abbydes/ELEC5550_Group08_GITHUB/PCB PROTOTYPING/README.md

This folder contains the code used to verify hardware prototyping and the KiCad design files for the PCB
