abbydes/ELEC5550_Group08_GITHUB/USB/README.md

This folder contains the USB host and device examples for both HID and MSC USB subclasses.
