abbydes/ELEC5550_Group08_GITHUB/PCB PROTOTYPING/UART BRIDGE/README.md

This folder contains code for verifying the functional UART bridge
