abbydes/ELEC5550_Group08_GITHUB/MSC/usbtx_V1/readme.md

Polls for request for file on the UART and sends over the file via serial.
