abbydes/ELEC5550_Group08_GITHUB/PCB PROTOTYPING/ledpatch/README.md

Please follow the instructions in the file to implement the LED code into the main code. By default pin 6 is the LED power out.
