abbydes/ELEC5550_Group08_GITHUB/HID/code_flow_diagram_hid_device.png

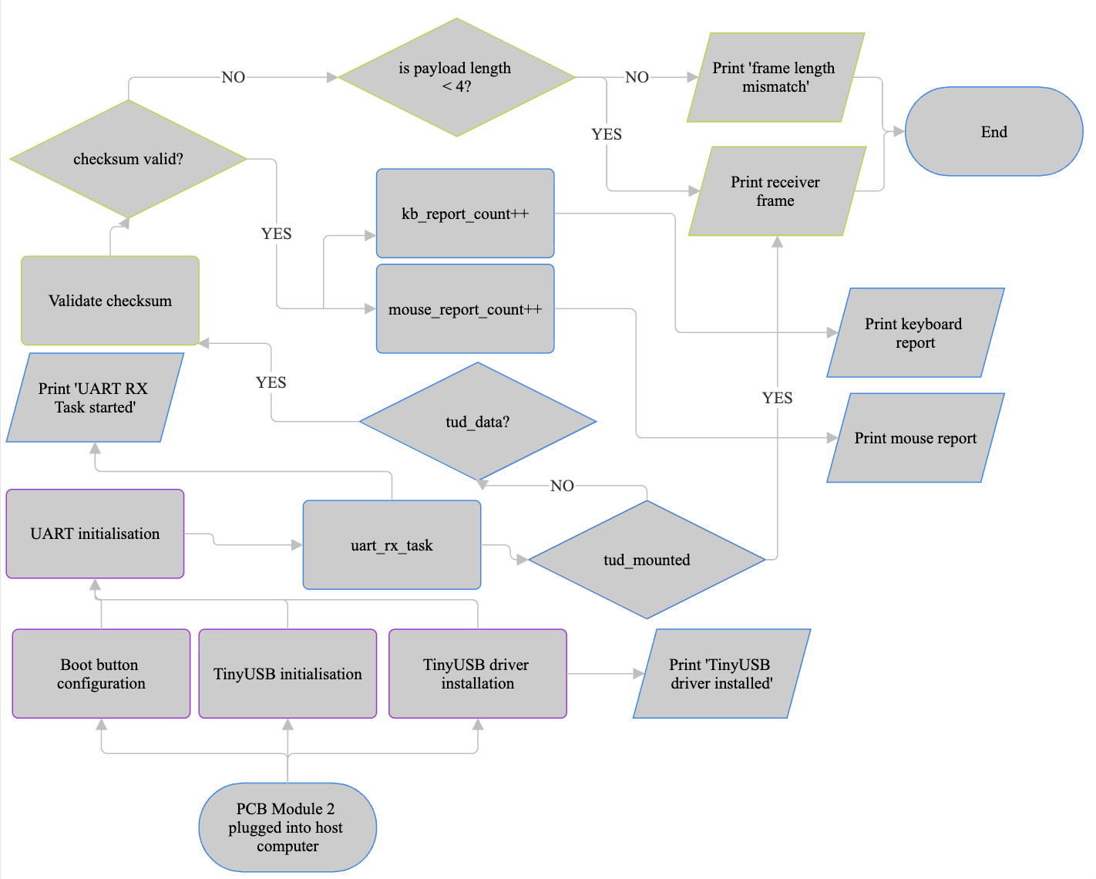
HID/code_flow_diagram_hid_device.png
