abbydes/ELEC5550_Group08_GITHUB/MSC/dev_main_V9/Module A Code Flow Diagram.png

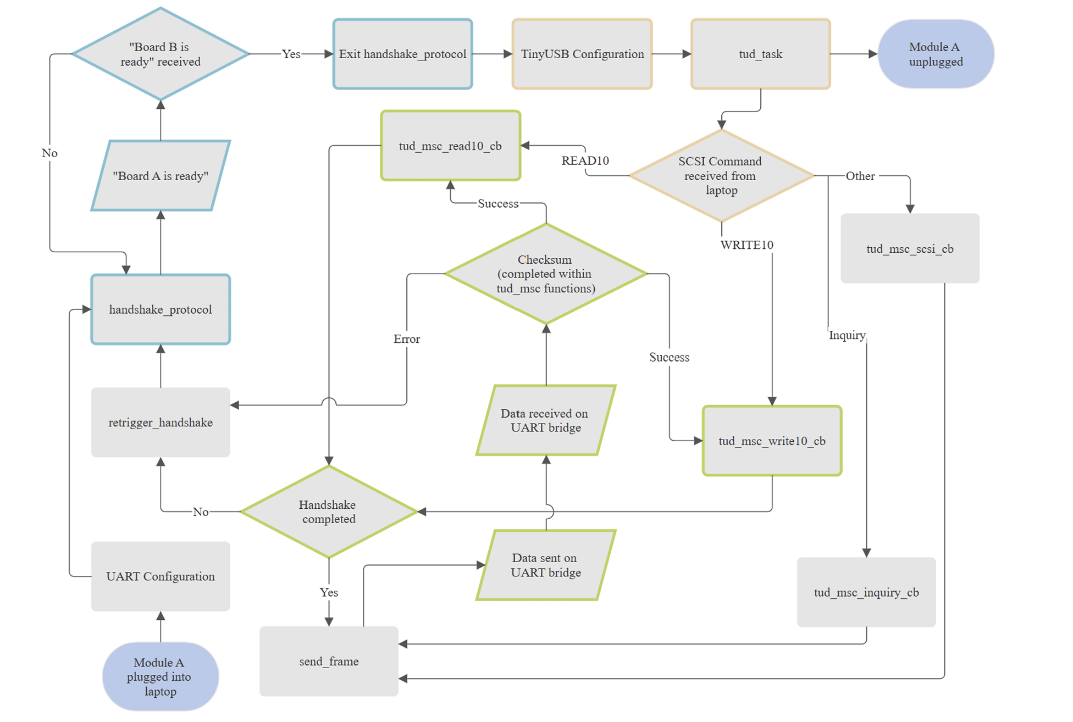
MSC/dev_main_V9/Module A Code Flow Diagram.png
