abbydes/ELEC5550_Group08_GITHUB/MSC/host_main_V8/Module B Code Flow Diagram.png

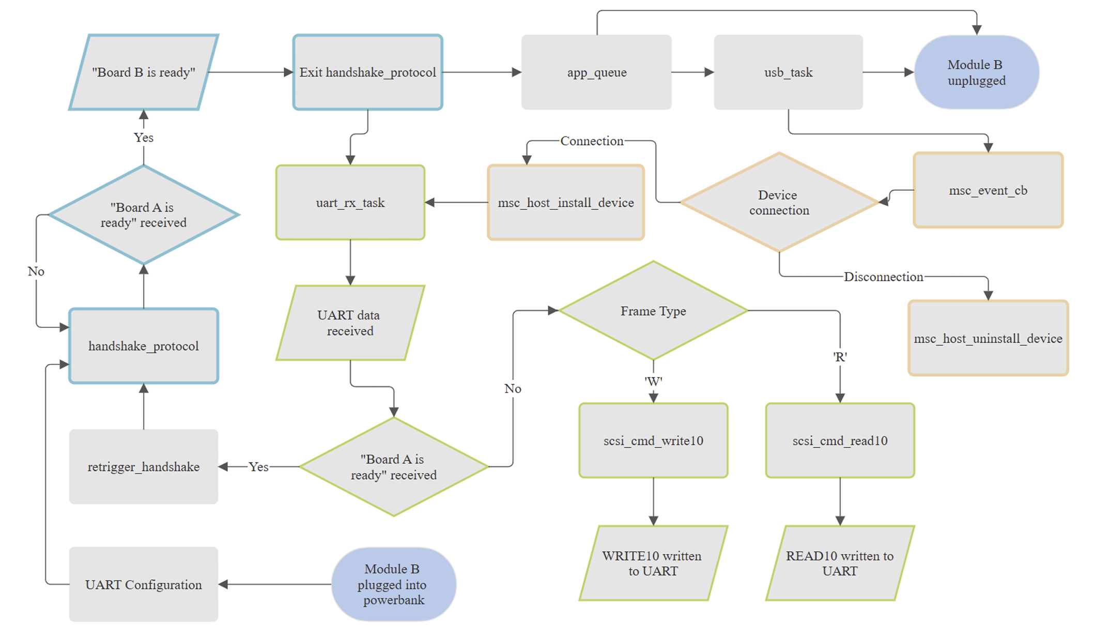
MSC/host_main_V8/Module B Code Flow Diagram.png
