abbydes/ELEC5550_Group08_GITHUB/PCB PROTOTYPING/KICAD DESIGN/IMPORTED COMPONENTS/README.md

This folder contains the necessary 3D models, symbols and footprints for the imported components used for the PCB design
