abbydes/ELEC5550_Group08_GITHUB/PCB PROTOTYPING/KICAD DESIGN/IMPORTED COMPONENTS/ESD9B5.0ST5G.stp

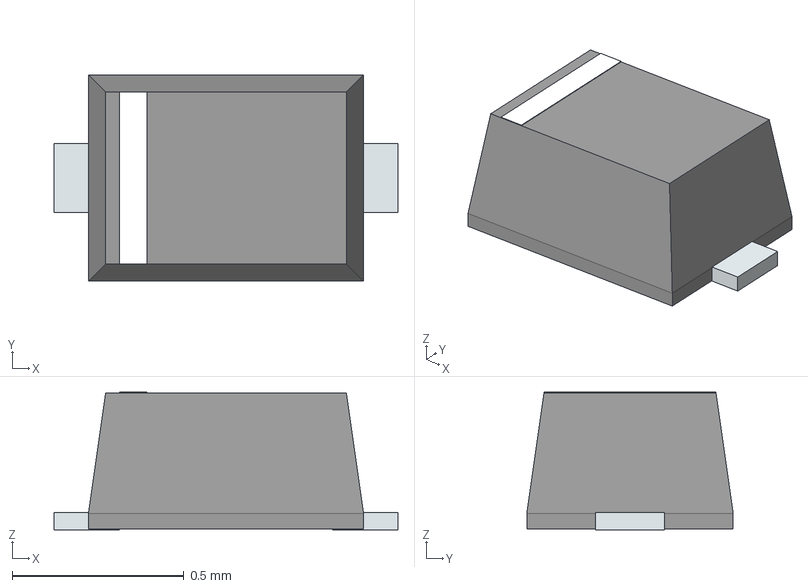
[picture p5: CAD file, 2025-10-27]
PCB PROTOTYPING/KICAD DESIGN/IMPORTED COMPONENTS/ESD9B5.0ST5G.stp
1.00 x 0.6 x 0.4 mm
PinKIdent
PinK
PinA
