abbydes/ELEC5550_Group08_GITHUB/PCB PROTOTYPING/KICAD DESIGN/IMPORTED COMPONENTS/ESP32-S3-WROOM-1-N8.stp

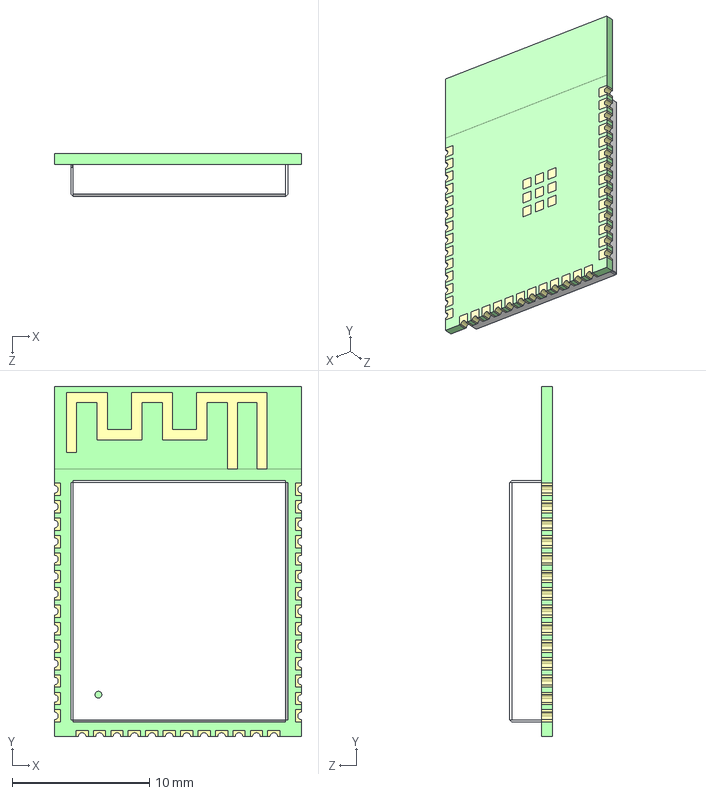
[picture p6: CAD file, 2025-10-27]
PCB PROTOTYPING/KICAD DESIGN/IMPORTED COMPONENTS/ESP32-S3-WROOM-1-N8.stp
18.0 x 25.5 x 3.10 mm
