abbydes/ELEC5550_Group08_GITHUB/PCB PROTOTYPING/KICAD DESIGN/IMPORTED COMPONENTS/USB4216-03-A.stp

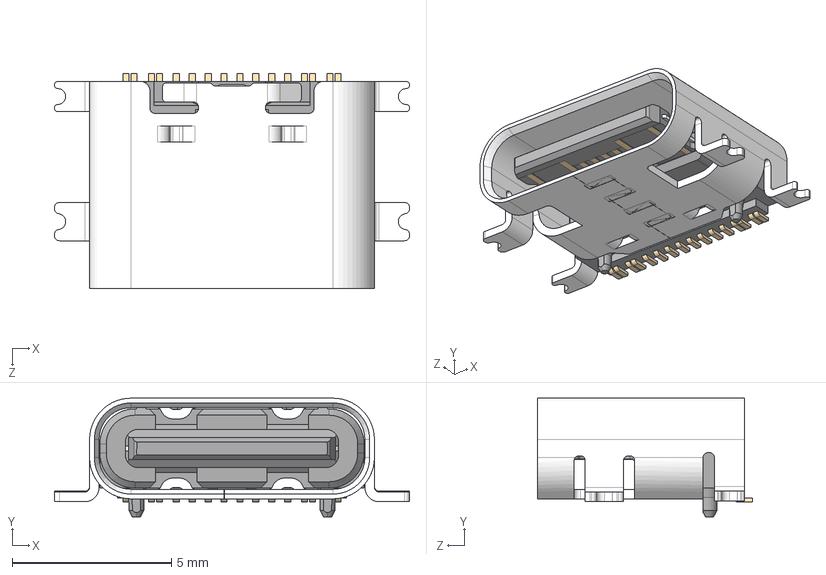
[picture p7: CAD file, 2025-10-27]
PCB PROTOTYPING/KICAD DESIGN/IMPORTED COMPONENTS/USB4216-03-A.stp
11.1 x 3.73 x 6.75 mm
USB4216 Shell
USB4216 Housing&Terminal
