abbydes/ELEC5550_Group08_GITHUB/PCB PROTOTYPING/KICAD DESIGN/IMPORTED COMPONENTS/LD1117AV33.stp

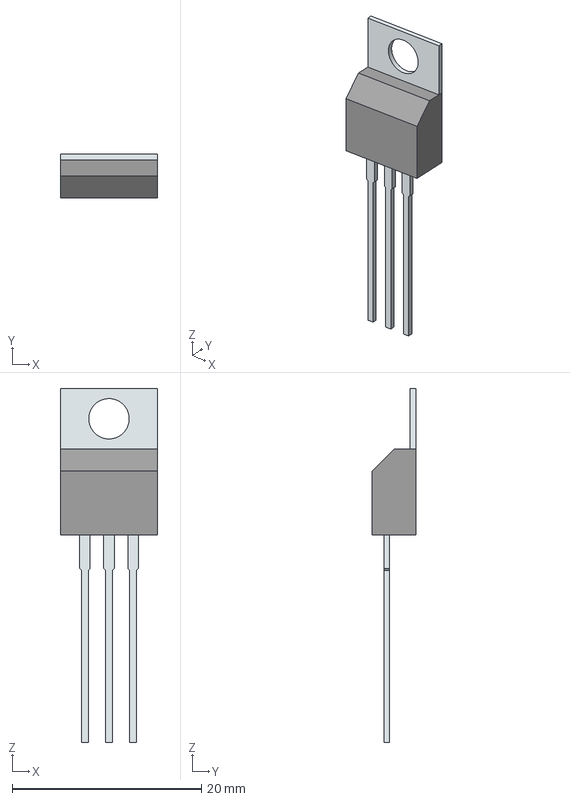
[picture p8: CAD file, 2025-10-27]
PCB PROTOTYPING/KICAD DESIGN/IMPORTED COMPONENTS/LD1117AV33.stp
10.2 x 4.60 x 37.4 mm
Tab
PinsArray
