abbydes/ELEC5550_Group08_GITHUB/PCB PROTOTYPING/KICAD DESIGN/IMPORTED COMPONENTS/TS18-5-15-SL-160-SMT-TR.stp

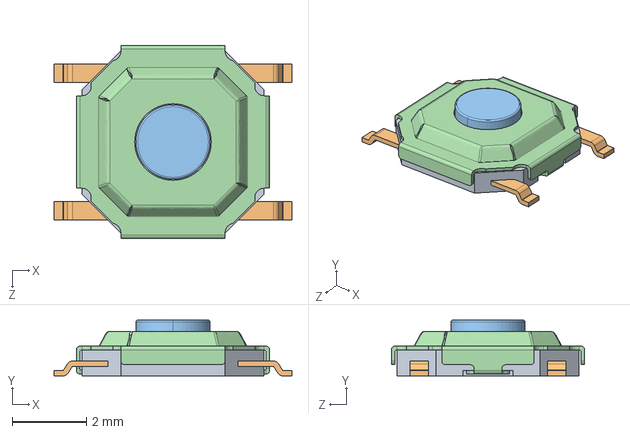
[picture p9: CAD file, 2025-10-27]
PCB PROTOTYPING/KICAD DESIGN/IMPORTED COMPONENTS/TS18-5-15-SL-160-SMT-TR.stp
6.40 x 1.50 x 5.20 mm
