abbydes/ELEC5550_Group08_GITHUB/PCB PROTOTYPING/KICAD DESIGN/IMPORTED COMPONENTS/TSM41YJ103KR05.stp

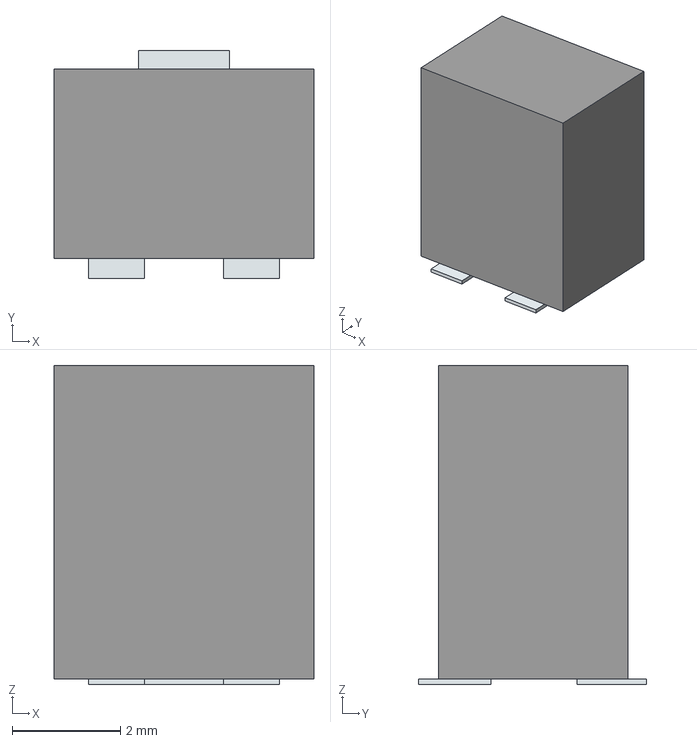
[picture p10: CAD file, 2025-10-27]
PCB PROTOTYPING/KICAD DESIGN/IMPORTED COMPONENTS/TSM41YJ103KR05.stp
4.80 x 4.21 x 5.90 mm
Pins
