abbydes/ELEC5550_Group08_GITHUB/PCB PROTOTYPING/KICAD DESIGN/IMPORTED COMPONENTS/LD1117S50TR.stp

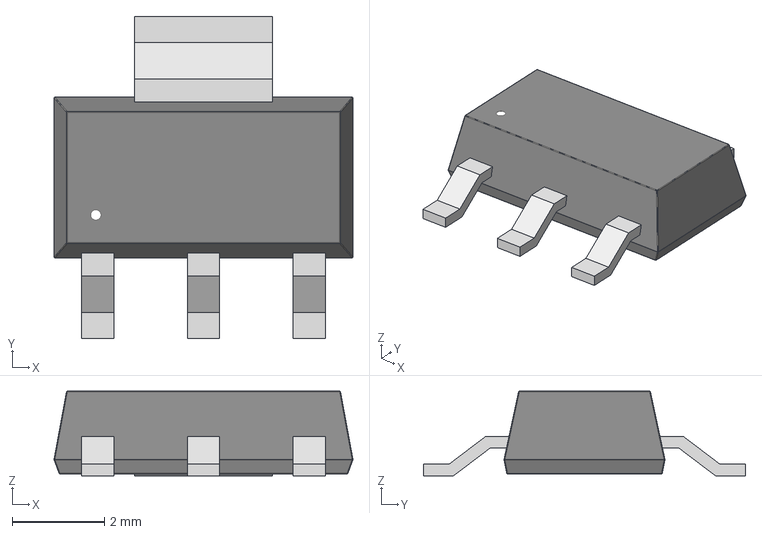
[picture p11: CAD file, 2025-10-27]
PCB PROTOTYPING/KICAD DESIGN/IMPORTED COMPONENTS/LD1117S50TR.stp
6.50 x 7.00 x 1.84 mm
