abbydes/ELEC5550_Group08_GITHUB/PCB PROTOTYPING/KICAD DESIGN/IMPORTED COMPONENTS/OPA323IDCKR.stp

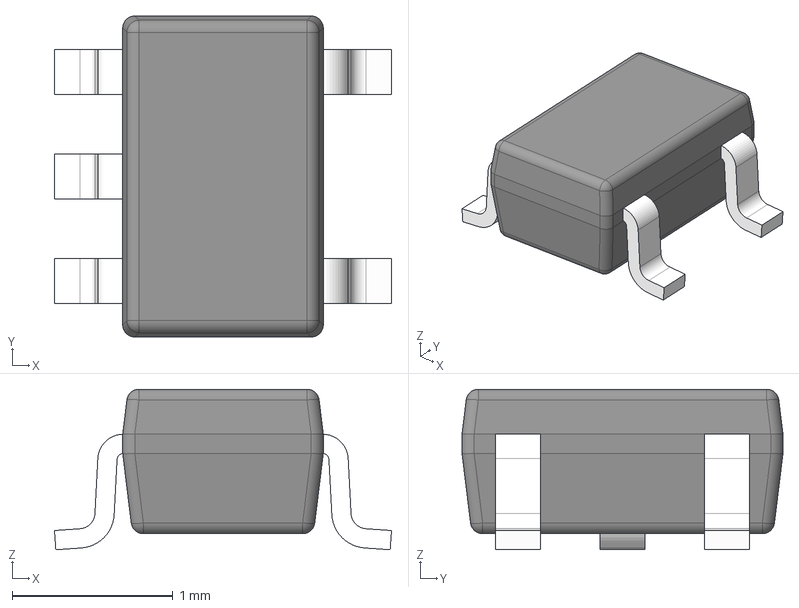
[picture p12: CAD file, 2025-10-27]
PCB PROTOTYPING/KICAD DESIGN/IMPORTED COMPONENTS/OPA323IDCKR.stp
2.10 x 2.00 x 1.00 mm
BODY-SOT
LEAD-SOT x 5
PIN1-ID
