abbydes/ELEC5550_Group08_GITHUB/PCB PROTOTYPING/KICAD DESIGN/IMPORTED COMPONENTS/VEMD5060X01.stp

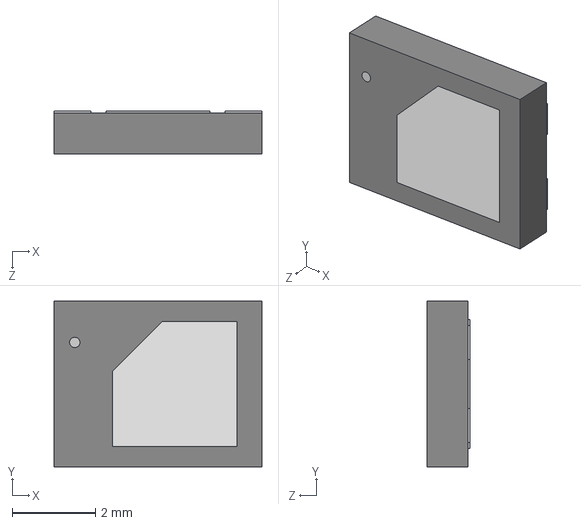
[picture p13: CAD file, 2025-10-27]
PCB PROTOTYPING/KICAD DESIGN/IMPORTED COMPONENTS/VEMD5060X01.stp
5.00 x 3.99 x 1.04 mm
