abbydes/ELEC5550_Group08_GITHUB/PCB PROTOTYPING/KICAD DESIGN/IMPORTED COMPONENTS/CP2102N-A02-GQFN28.stp

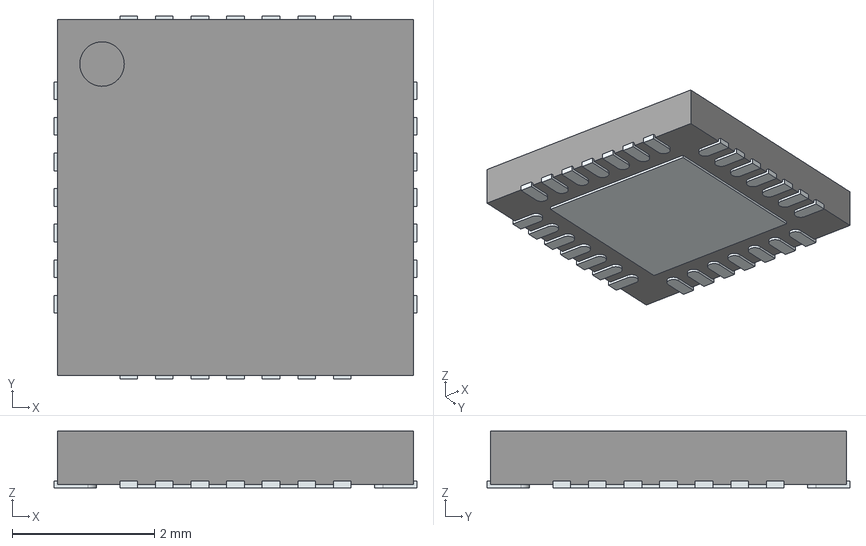
[picture p14: CAD file, 2025-10-27]
PCB PROTOTYPING/KICAD DESIGN/IMPORTED COMPONENTS/CP2102N-A02-GQFN28.stp
5.10 x 5.10 x 0.8 mm
ThermalPin
PinsArrayLR
PinsArrayTB
