abbydes/ELEC5550_Group08_GITHUB/PCB PROTOTYPING/KICAD DESIGN/IMPORTED COMPONENTS/3296W-1-105LF.stp

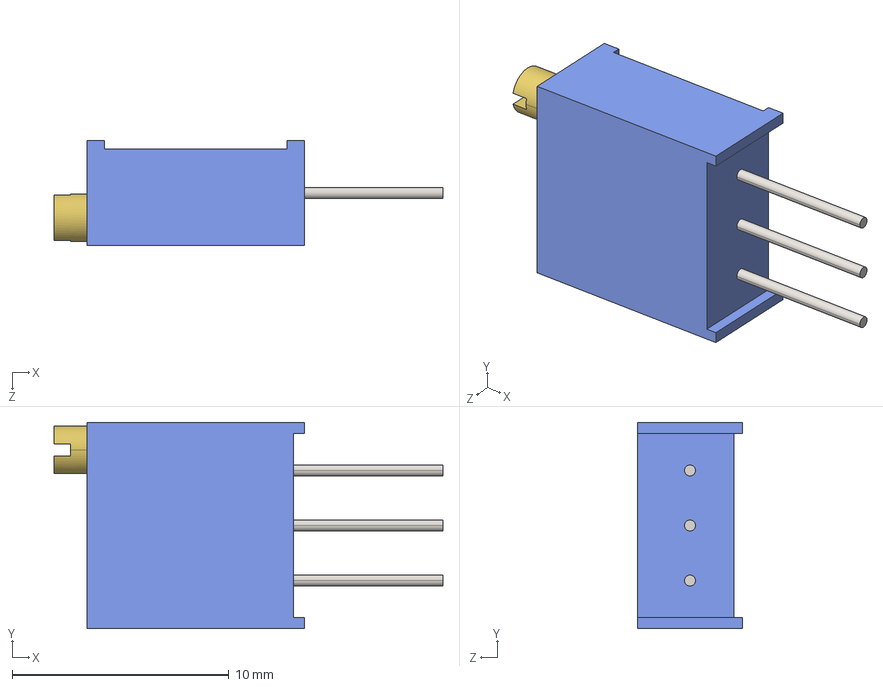
[picture p15: CAD file, 2025-10-27]
PCB PROTOTYPING/KICAD DESIGN/IMPORTED COMPONENTS/3296W-1-105LF.stp
18.0 x 9.52 x 4.83 mm
