abbydes/ELEC5550_Group08_GITHUB/PCB PROTOTYPING/KICAD DESIGN/IMPORTED COMPONENTS/OPA350UA.stp

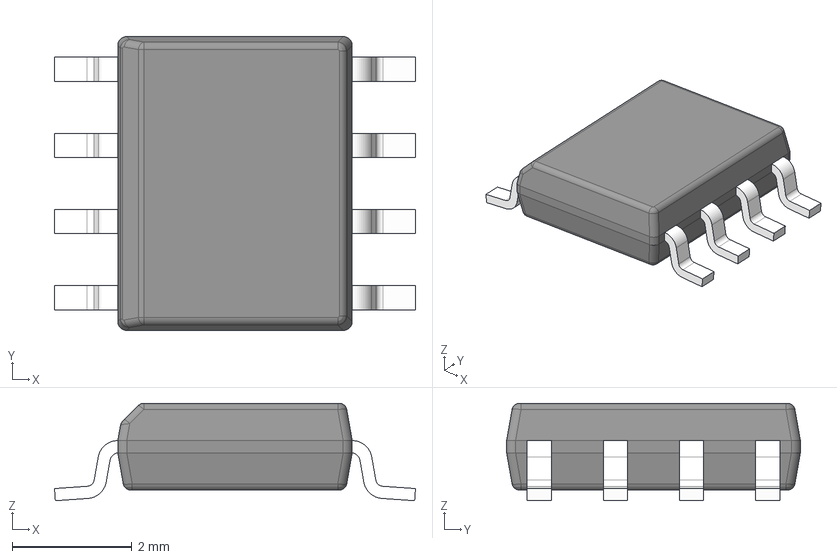
[picture p16: CAD file, 2025-10-27]
PCB PROTOTYPING/KICAD DESIGN/IMPORTED COMPONENTS/OPA350UA.stp
6.02 x 4.90 x 1.63 mm
BODY-SO
LEAD-D0008A x 8
