abbydes/ELEC5550_Group08_GITHUB/PCB PROTOTYPING/KICAD DESIGN/IMPORTED COMPONENTS/PTS647SN50SMTR2_LFS.stp

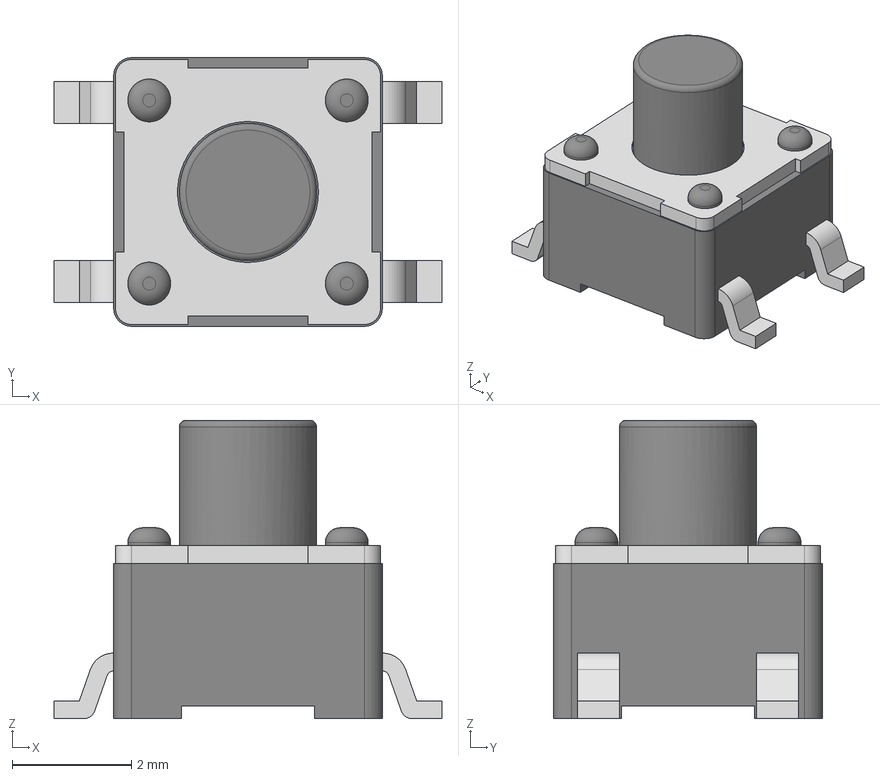
[picture p17: CAD file, 2025-10-27]
PCB PROTOTYPING/KICAD DESIGN/IMPORTED COMPONENTS/PTS647SN50SMTR2_LFS.stp
6.50 x 4.50 x 5.00 mm
