abbydes/ELEC5550_Group08_GITHUB/PCB PROTOTYPING/KICAD DESIGN/IMPORTED COMPONENTS/1N5819HW-7-F.stp

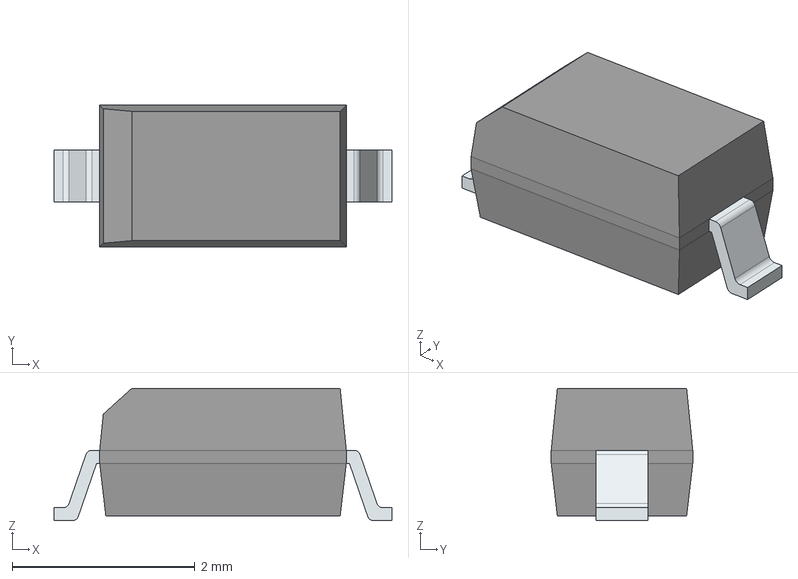
[picture p18: CAD file, 2025-10-27]
PCB PROTOTYPING/KICAD DESIGN/IMPORTED COMPONENTS/1N5819HW-7-F.stp
3.70 x 1.55 x 1.45 mm
FilletPinL
FilletPinR
