abbydes/ELEC5550_Group08_GITHUB/PCB PROTOTYPING/KICAD DESIGN/IMPORTED COMPONENTS/AP2112K-3.3TRG1.stp

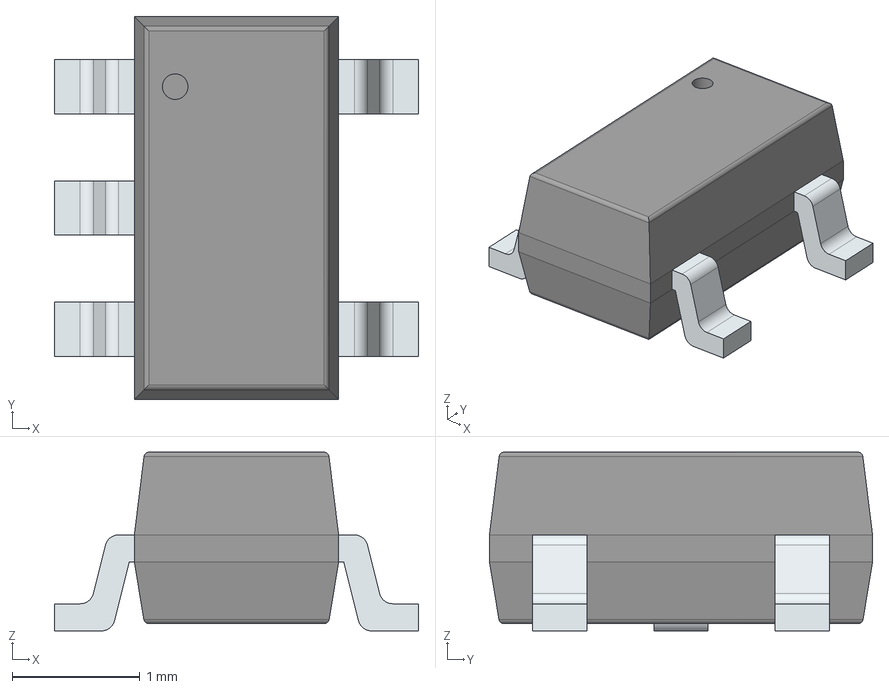
[picture p19: CAD file, 2025-10-27]
PCB PROTOTYPING/KICAD DESIGN/IMPORTED COMPONENTS/AP2112K-3.3TRG1.stp
2.85 x 3.00 x 1.40 mm
PinsArrayL
PinsArrayR
