abbydes/ELEC5550_Group08_GITHUB/PCB PROTOTYPING/KICAD DESIGN/IMPORTED COMPONENTS/DIODE_TEMD5010_VIS.step

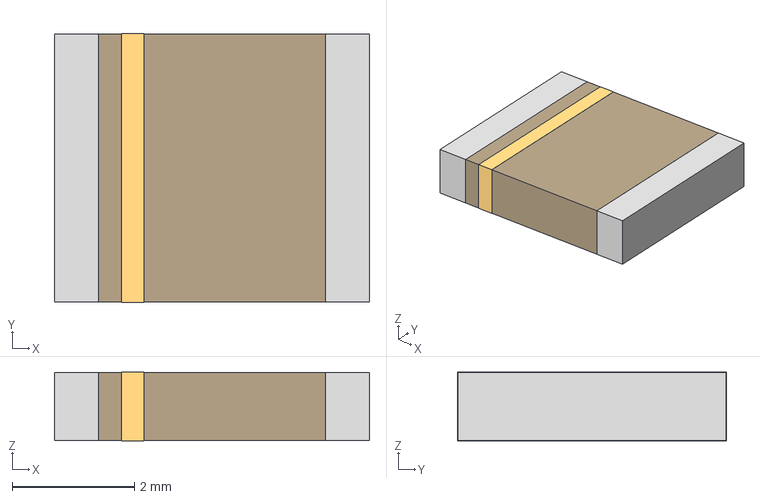
[picture p20: CAD file, 2025-10-27]
PCB PROTOTYPING/KICAD DESIGN/IMPORTED COMPONENTS/DIODE_TEMD5010_VIS.step
5.16 x 4.40 x 1.12 mm

PCB PROTOTYPING/KICAD DESIGN/IMPORTED COMPONENTS/OPA380AIDGKR.stp
4.90 x 3.00 x 1.10 mm
BODY_MUA08A
LEAD_MUA08A x 8
