abbydes/ELEC5550_Group08_GITHUB/(list of files, cad)

Other CAD files:
PCB PROTOTYPING/KICAD DESIGN/IMPORTED COMPONENTS/CP2102N-A02-GQFN28R.stp
PCB PROTOTYPING/KICAD DESIGN/IMPORTED COMPONENTS/TLV75733PDRVR.stp
