abbydes/ELEC5550_Group08_GITHUB/PCB PROTOTYPING/KICAD DESIGN/ESP32-S3-DevKitC-1.kicad_pcb

## KiCad design PCB PROTOTYPING/KICAD DESIGN/ESP32-S3-DevKitC-1.kicad_pcb (2025-10-27)

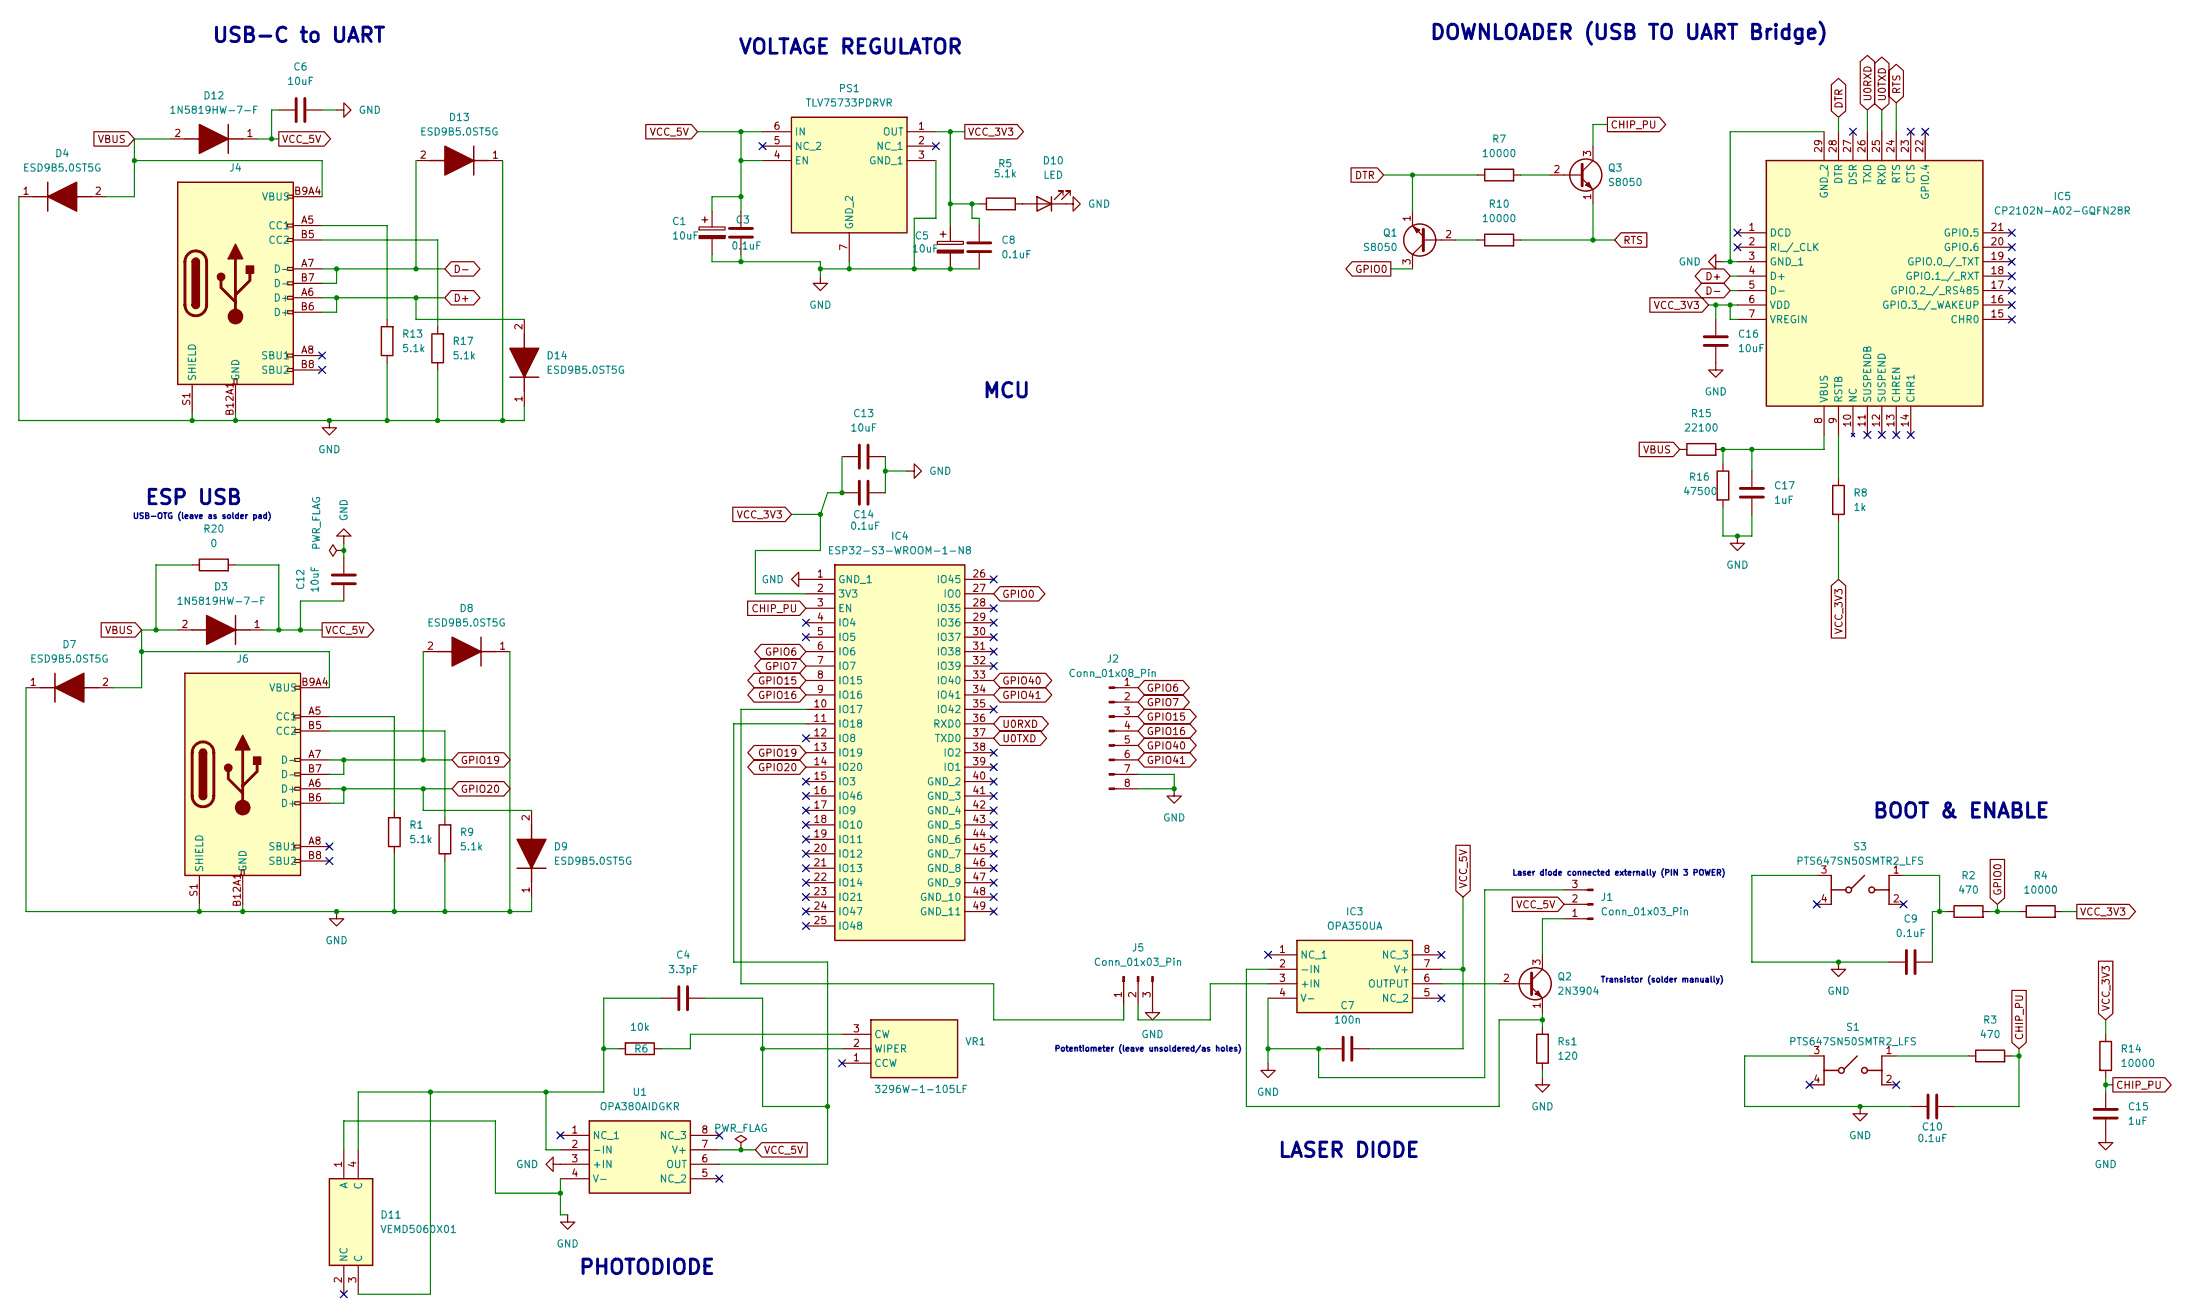
[picture p22: schematic ESP32-S3-DevKitC-1.kicad_sch]

Parts:
C1, C5, C6, C12, C13, C16: 10uF; C_0805_2012Metric
C3, C8, C9, C10, C14: 0.1uF; C_0805_2012Metric
C4: 3.3pF; C_0805_2012Metric
C7: 100n; C_0805_2012Metric
C15, C17: 1uF; C_0805_2012Metric
D3, D12: 1N5819HW-7-F; SOD3716X145N; Mouser Part Number 621-1N5819HW-F
D4, D7, D8, D9, D13, D14: ESD9B5.0ST5G; SODFL1006X40N; Mouser Part Number 863-ESD9B5.0ST5G
D10: LED; LED_0805_2012Metric
D11: VEMD5060X01; Mouser Part Number 78-VEMD5060X01
IC3: OPA350UA; SOIC127P600X175-8N; Mouser Part Number 595-OPA350UA
IC4: ESP32-S3-WROOM-1-N8; ESP32S3WROOM1N8R2; Mouser Part Number 356-ESP32-S3WROOM1N8
IC5: CP2102N-A02-GQFN28R; QFN50P500X500X80-29N-D; Mouser Part Number 634-CP2102NA02QFN28R
J1, J5: Conn_01x03_Pin; PinHeader_1x03_P2.54mm_Vertical
J2: Conn_01x08_Pin; PinHeader_1x08_P2.54mm_Vertical
J4, J6: Connector, USB-TYPE-C-16P; TYPE-C-SMD_HX-TYPE-C-16PIN; LCSC C2927039
PS1: TLV75733PDRVR; SON65P200X200X80-7N; Mouser Part Number 595-TLV75733PDRVR
Q1, Q3: S8050; TO-92_Inline
Q2: 2N3904; TO-92_Inline
R1, R5, R9, R13, R17: 5.1k; R_0805_2012Metric
R2, R3: 470; R_0805_2012Metric
R4, R7, R10, R14: 10000; R_0805_2012Metric
R6: 10k; R_0805_2012Metric
R8: 1k; R_0805_2012Metric
R15: 22100; R_0805_2012Metric
R16: 47500; R_0805_2012Metric
R20: 0; R_0805_2012Metric
Rs1: 120; R_0805_2012Metric
S1, S3: PTS647SN50SMTR2_LFS; PTS647SK50SMTR2LFS; Manufacturer_Part_Number PTS647SN50SMTR2 LFS
U1: OPA380AIDGKR; SOP65P490X110-8N; Mouser Part Number 595-OPA380AIDGKR
VR1: 3296W-1-105LF; 3296W1503LF; Mouser Part Number 652-3296W-1-105LF

Connections:
CHIP_PU: C10.2, C15.2, IC4.3 (EN), Q3.3 (C), R3.2, R14.2
D+: D14.2 (A), IC5.4 (D+), J4.A6 (D+), J4.B6 (D+)
D-: D13.2 (A), IC5.5 (D-), J4.A7 (D-), J4.B7 (D-)
DTR: IC5.28 (DTR), Q1.1 (E), R7.1
GND: C1.2, C3.2, C5.2, C6.2, C7.2, C8.2, C9.1, C10.1, C12.2, C13.2, C14.2, C15.1, C16.1, C17.1, D4.1 (K), D7.1 (K), D8.1 (K), D9.1 (K), D10.1 (K), D11.1 (A), D13.1 (K), D14.1 (K), IC3.4 (V-), IC4.1 (GND_1), IC5.3 (GND_1), IC5.29 (GND_2), J1.3, J2.7, J2.8, J4.A12B1 (GND), J4.B12A1 (GND), J4.S1 (SHIELD), J5.3, J6.A12B1 (GND), J6.B12A1 (GND), J6.S1 (SHIELD), PS1.3 (GND_1), PS1.7 (GND_2), R1.1, R9.1, R13.1, R16.2, R17.1, Rs1.1, S1.3 (COM_1), S3.3 (COM_1), U1.3 (+IN), U1.4 (V-)
GPIO0: IC4.27 (IO0), Q1.3 (C), R2.2, R4.1
GPIO6: IC4.6 (IO6), J2.1
GPIO7: IC4.7 (IO7), J2.2
GPIO15: IC4.8 (IO15), J2.3
GPIO16: IC4.9 (IO16), J2.4
GPIO19: D8.2 (A), IC4.13 (IO19), J6.A7 (D-), J6.B7 (D-)
GPIO20: D9.2 (A), IC4.14 (IO20), J6.A6 (D+), J6.B6 (D+)
GPIO40: IC4.33 (IO40), J2.5
GPIO41: IC4.34 (IO41), J2.6
unnamed: D10.2 (A), R5.2
unnamed: IC3.3 (+IN), J5.2
unnamed: IC3.2 (-IN), Q2.1 (E), Rs1.2
unnamed: IC3.6 (OUTPUT), Q2.2 (B)
unnamed: IC4.10 (IO17), J5.1
unnamed: C4.1, IC4.11 (IO18), U1.6 (OUT), VR1.2 (WIPER)
unnamed: IC5.9 (RSTB), R8.1
unnamed: C17.2, IC5.8 (VBUS), R15.2, R16.1
unnamed: J1.1, Q2.3 (C)
unnamed: J4.A5 (CC1), R13.2
unnamed: J4.B5 (CC2), R17.2
unnamed: J6.A5 (CC1), R1.2
unnamed: J6.B5 (CC2), R9.2
unnamed: Q1.2 (B), R10.1
unnamed: Q3.2 (B), R7.2
unnamed: R3.1, S1.1 (NO_1)
unnamed: C9.2, R2.1, S3.1 (NO_1)
unnamed: C4.2, D11.3 (C), D11.4 (C), R6.2, U1.2 (-IN)
unnamed: R6.1, VR1.3 (CW)
RTS: IC5.24 (RTS), Q3.1 (E), R10.2
U0RXD: IC4.36 (RXD0), IC5.26 (TXD)
U0TXD: IC4.37 (TXD0), IC5.25 (RXD)
VBUS: D3.2 (A), D4.2 (A), D7.2 (A), D12.2 (A), J4.A9B4 (VBUS), J4.B9A4 (VBUS), J6.A9B4 (VBUS), J6.B9A4 (VBUS), R15.1, R20.1
VCC_3V3: C5.1, C8.1, C13.1, C14.1, C16.2, IC4.2 (3V3), IC5.6 (VDD), IC5.7 (VREGIN), PS1.1 (OUT), R4.2, R5.1, R8.2, R14.1
VCC_5V: C1.1, C3.1, C6.1, C7.1, C12.1, D3.1 (K), D12.1 (K), IC3.7 (V+), J1.2, PS1.4 (EN), PS1.6 (IN), R20.2, U1.7 (V+)

Notes on the sheet:
LASER DIODE
MCU
BOOT & ENABLE
USB-OTG (leave as solder pad)
PHOTODIODE
Potentiometer (leave unsoldered/as holes)
USB-C to UART
Laser diode connected externally (PIN 3 POWER)
VOLTAGE REGULATOR
Transistor (solder manually)
ESP USB
DOWNLOADER (USB TO UART Bridge)

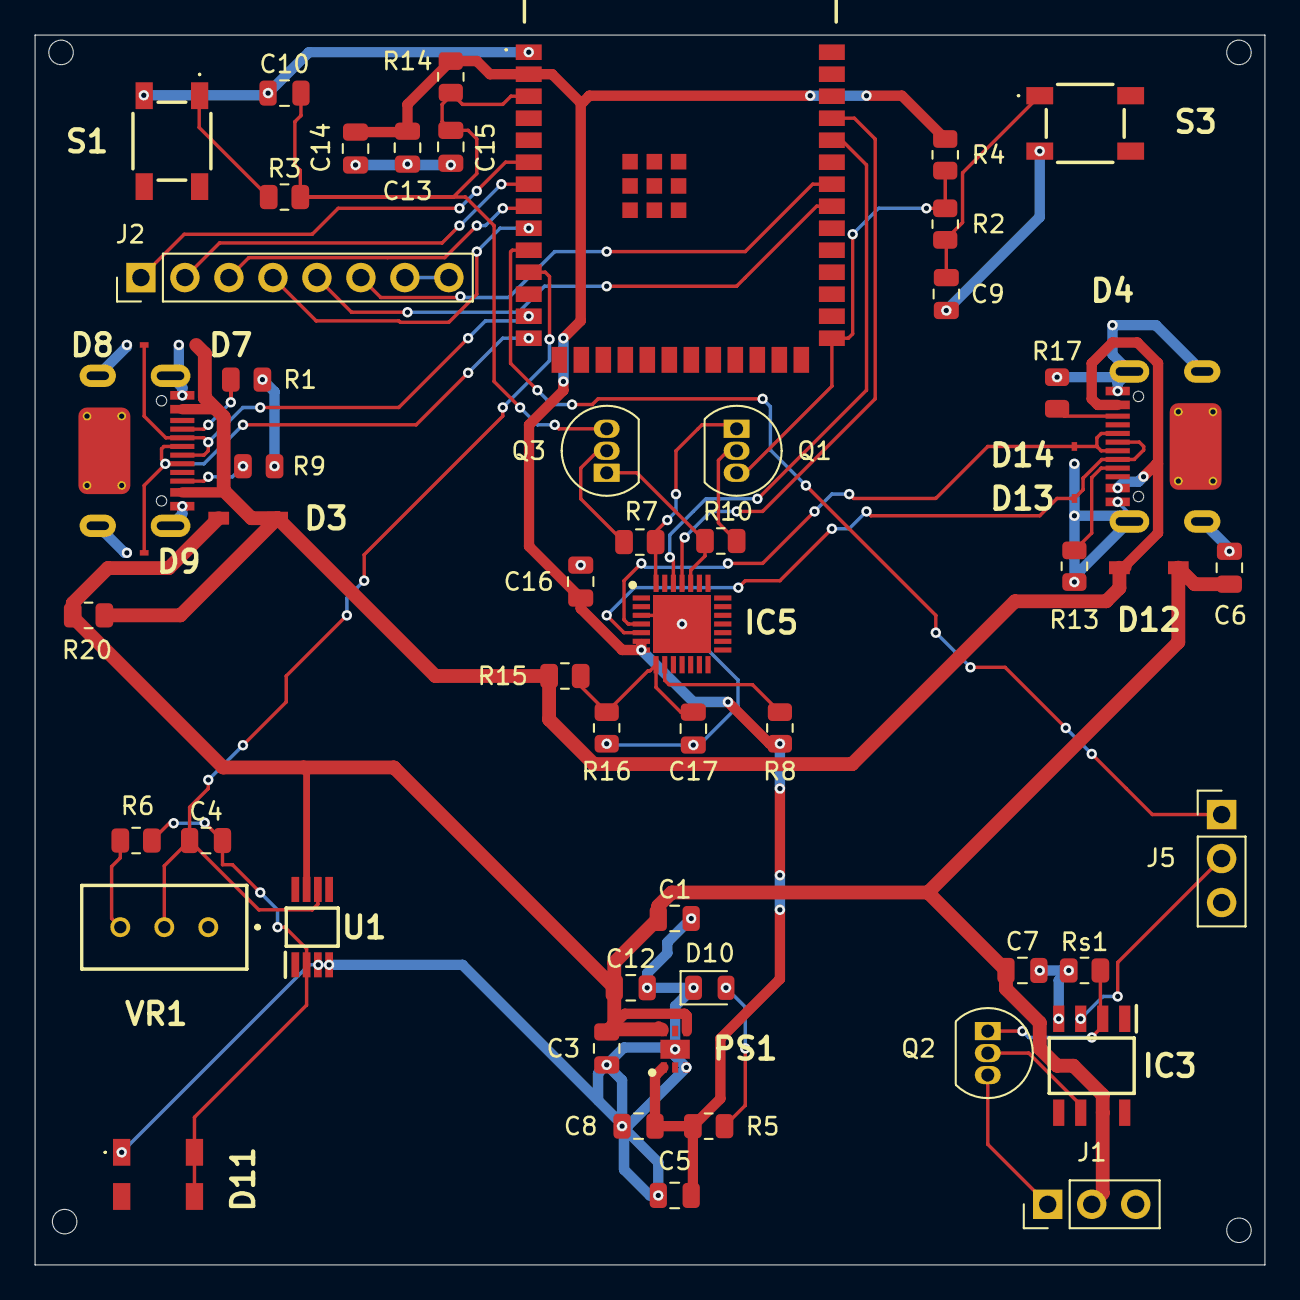
[picture p23: board ESP32-S3-DevKitC-1.kicad_pcb from above]

Board: 2 copper layers, 71.0 x 71.0 mm, 58 parts (0 on the bottom side), 39 nets.
