abbydes/ELEC5550_Group08_GITHUB/HID/hid_v1.c

/*
 * SPDX-FileCopyrightText: 2022-2025 Espressif Systems (Shanghai) CO LTD
 *
 * SPDX-License-Identifier: Unlicense OR CC0-1.0
 */

#include <stdio.h>
#include <stdbool.h>
#include <string.h>
#include <unistd.h>
#include "freertos/FreeRTOS.h"
#include "freertos/task.h"
#include "freertos/event_groups.h"
#include "freertos/queue.h"
#include "esp_err.h"
#include "esp_log.h"
#include "usb/usb_host.h"
#include "errno.h"
#include "driver/gpio.h"
#include "usb/hid_host.h"
#include "usb/hid_usage_keyboard.h"
#include "usb/hid_usage_mouse.h"
#include "driver/uart.h"
#include "string.h"

#include <stdlib.h>
#include "tinyusb.h"
#include "class/hid/hid_device.h"

/* GPIO Pin number for quit from example logic */
#define APP_QUIT_PIN                GPIO_NUM_0

static const char *TAG = "example";

// ---------------- UART framing to GPIO17 (ESP32-S3) ----------------
#define SERIAL_UART_NUM   UART_NUM_1
#define SERIAL_TX_GPIO    17
#define SERIAL_BAUD       115200
#define SERIAL_MAGIC      0xA5
#define UART_RX_PIN        18              // Match sender TX, supposed to be GPIO18
#define UART_BUF_SIZE      1024

static inline uint8_t checksum8(const uint8_t *data, size_t len)
{
    uint32_t s = 0;
    for (size_t i = 0; i < len; i++) {
        s += data[i];
    }
    return (uint8_t)(s & 0xFF);
}

static void uart_init(void)
{
    const uart_config_t cfg = {
        .baud_rate = SERIAL_BAUD,
        .data_bits = UART_DATA_8_BITS,
        .parity    = UART_PARITY_DISABLE,
        .stop_bits = UART_STOP_BITS_1,
        .flow_ctrl = UART_HW_FLOWCTRL_DISABLE,
        .source_clk = UART_SCLK_DEFAULT,
    };
    // Minimal RX buffer (we only TX), no event queue
    ESP_ERROR_CHECK(uart_driver_install(SERIAL_UART_NUM, 256, 0, 0, NULL, 0));
    ESP_ERROR_CHECK(uart_param_config(SERIAL_UART_NUM, &cfg));
    ESP_ERROR_CHECK(uart_set_pin(SERIAL_UART_NUM, SERIAL_TX_GPIO,
                                 UART_PIN_NO_CHANGE, UART_PIN_NO_CHANGE,
                                 UART_PIN_NO_CHANGE));
}

// Send one framed packet over UART (TYPE: 'K'/'M'/'R')
static void uart_send_framed(uint8_t type, const uint8_t *payload, size_t len)
{
    if (!payload || len > 250) return; // sanity limit

    uint8_t hdr[3] = { SERIAL_MAGIC, type, (uint8_t)len };

    // Compute checksum over TYPE + LEN + payload
    uint32_t sum = hdr[1] + hdr[2];
    for (size_t i = 0; i < len; i++) {
        sum += payload[i];
    }
    uint8_t cs = (uint8_t)(0x100 - (sum & 0xFF));

    uint8_t buf[3 + len + 1];
    memcpy(buf, hdr, 3);
    memcpy(buf + 3, payload, len);
    buf[3 + len] = cs;

    //Send out over UART
    (void)uart_write_bytes(SERIAL_UART_NUM, (const char *)buf, sizeof(buf));
}
// -------------------------------------------------------------------


QueueHandle_t app_event_queue = NULL;

/**
 * @brief APP event group
 *
 * Application logic can be different. There is a one among other ways to distinguish the
 * event by application event group.
 * In this example we have two event groups:
 * APP_EVENT            - General event, which is APP_QUIT_PIN press event (Generally, it is IO0).
 * APP_EVENT_HID_HOST   - HID Host Driver event, such as device connection/disconnection or input report.
 */
typedef enum {
    APP_EVENT = 0,
    APP_EVENT_HID_HOST
} app_event_group_t;

/**
 * @brief APP event queue
 *
 * This event is used for delivering the HID Host event from callback to a task.
 */
typedef struct {
    app_event_group_t event_group;
    /* HID Host - Device related info */
    struct {
        hid_host_device_handle_t handle;
        hid_host_driver_event_t event;
        void *arg;
    } hid_host_device;
} app_event_queue_t;

/**
 * @brief HID Protocol string names
 */
static const char *hid_proto_name_str[] = {
    "NONE",
    "KEYBOARD",
    "MOUSE"
};

/**
 * @brief Key event
 */
typedef struct {
    enum key_state {
        KEY_STATE_PRESSED = 0x00,
        KEY_STATE_RELEASED = 0x01
    } state;
    uint8_t modifier;
    uint8_t key_code;
} key_event_t;

/* Main char symbol for ENTER key */
#define KEYBOARD_ENTER_MAIN_CHAR    '\r'
/* When set to 1 pressing ENTER will be extending with LineFeed during serial debug output */
#define KEYBOARD_ENTER_LF_EXTEND    1

/**
 * @brief Scancode to ascii table
 */
const uint8_t keycode2ascii [57][2] = {
    {0, 0}, /* HID_KEY_NO_PRESS        */
    {0, 0}, /* HID_KEY_ROLLOVER        */
    {0, 0}, /* HID_KEY_POST_FAIL       */
    {0, 0}, /* HID_KEY_ERROR_UNDEFINED */
    {'a', 'A'}, /* HID_KEY_A               */
    {'b', 'B'}, /* HID_KEY_B               */
    {'c', 'C'}, /* HID_KEY_C               */
    {'d', 'D'}, /* HID_KEY_D               */
    {'e', 'E'}, /* HID_KEY_E               */
    {'f', 'F'}, /* HID_KEY_F               */
    {'g', 'G'}, /* HID_KEY_G               */
    {'h', 'H'}, /* HID_KEY_H               */
    {'i', 'I'}, /* HID_KEY_I               */
    {'j', 'J'}, /* HID_KEY_J               */
    {'k', 'K'}, /* HID_KEY_K               */
    {'l', 'L'}, /* HID_KEY_L               */
    {'m', 'M'}, /* HID_KEY_M               */
    {'n', 'N'}, /* HID_KEY_N               */
    {'o', 'O'}, /* HID_KEY_O               */
    {'p', 'P'}, /* HID_KEY_P               */
    {'q', 'Q'}, /* HID_KEY_Q               */
    {'r', 'R'}, /* HID_KEY_R               */
    {'s', 'S'}, /* HID_KEY_S               */
    {'t', 'T'}, /* HID_KEY_T               */
    {'u', 'U'}, /* HID_KEY_U               */
    {'v', 'V'}, /* HID_KEY_V               */
    {'w', 'W'}, /* HID_KEY_W               */
    {'x', 'X'}, /* HID_KEY_X               */
    {'y', 'Y'}, /* HID_KEY_Y               */
    {'z', 'Z'}, /* HID_KEY_Z               */
    {'1', '!'}, /* HID_KEY_1               */
    {'2', '@'}, /* HID_KEY_2               */
    {'3', '#'}, /* HID_KEY_3               */
    {'4', '$'}, /* HID_KEY_4               */
    {'5', '%'}, /* HID_KEY_5               */
    {'6', '^'}, /* HID_KEY_6               */
    {'7', '&'}, /* HID_KEY_7               */
    {'8', '*'}, /* HID_KEY_8               */
    {'9', '('}, /* HID_KEY_9               */
    {'0', ')'}, /* HID_KEY_0               */
    {KEYBOARD_ENTER_MAIN_CHAR, KEYBOARD_ENTER_MAIN_CHAR}, /* HID_KEY_ENTER           */
    {0, 0}, /* HID_KEY_ESC             */
    {'\b', 0}, /* HID_KEY_DEL             */
    {0, 0}, /* HID_KEY_TAB             */
    {' ', ' '}, /* HID_KEY_SPACE           */
    {'-', '_'}, /* HID_KEY_MINUS           */
    {'=', '+'}, /* HID_KEY_EQUAL           */
    {'[', '{'}, /* HID_KEY_OPEN_BRACKET    */
    {']', '}'}, /* HID_KEY_CLOSE_BRACKET   */
    {'\\', '|'}, /* HID_KEY_BACK_SLASH      */
    {'\\', '|'}, /* HID_KEY_SHARP           */  // HOTFIX: for NonUS Keyboards repeat HID_KEY_BACK_SLASH
    {';', ':'}, /* HID_KEY_COLON           */
    {'\'', '"'}, /* HID_KEY_QUOTE           */
    {'`', '~'}, /* HID_KEY_TILDE           */
    {',', '<'}, /* HID_KEY_LESS            */
    {'.', '>'}, /* HID_KEY_GREATER         */
    {'/', '?'} /* HID_KEY_SLASH           */
};

/**
 * @brief Makes new line depending on report output protocol type
 *
 * @param[in] proto Current protocol to output
 */
static void hid_print_new_device_report_header(hid_protocol_t proto)
{
    static hid_protocol_t prev_proto_output = -1;

    if (prev_proto_output != proto) {
        prev_proto_output = proto;
        printf("\r\n");
        if (proto == HID_PROTOCOL_MOUSE) {
            printf("Mouse\r\n");
        } else if (proto == HID_PROTOCOL_KEYBOARD) {
            printf("Keyboard\r\n");
        } else {
            printf("Generic\r\n");
        }
        fflush(stdout);
    }
}

/**
 * @brief HID Keyboard modifier verification for capitalization application (right or left shift)
 *
 * @param[in] modifier
 * @return true  Modifier was pressed (left or right shift)
 * @return false Modifier was not pressed (left or right shift)
 *
 */
static inline bool hid_keyboard_is_modifier_shift(uint8_t modifier)
{
    if (((modifier & HID_LEFT_SHIFT) == HID_LEFT_SHIFT) ||
            ((modifier & HID_RIGHT_SHIFT) == HID_RIGHT_SHIFT)) {
        return true;
    }
    return false;
}

/**
 * @brief HID Keyboard get char symbol from key code
 *
 * @param[in] modifier  Keyboard modifier data
 * @param[in] key_code  Keyboard key code
 * @param[in] key_char  Pointer to key char data
 *
 * @return true  Key scancode converted successfully
 * @return false Key scancode unknown
 */
static inline bool hid_keyboard_get_char(uint8_t modifier,
                                         uint8_t key_code,
                                         unsigned char *key_char)
{
    uint8_t mod = (hid_keyboard_is_modifier_shift(modifier)) ? 1 : 0;

    if ((key_code >= HID_KEY_A) && (key_code <= HID_KEY_SLASH)) {
        *key_char = keycode2ascii[key_code][mod];
    } else {
        // All other key pressed
        return false;
    }

    return true;
}

/**
 * @brief HID Keyboard print char symbol
 *
 * @param[in] key_char  Keyboard char to stdout
 */
static inline void hid_keyboard_print_char(unsigned int key_char)
{
    if (!!key_char) {
        putchar(key_char);
#if (KEYBOARD_ENTER_LF_EXTEND)
        if (KEYBOARD_ENTER_MAIN_CHAR == key_char) {
            putchar('\n');
        }
#endif // KEYBOARD_ENTER_LF_EXTEND
        fflush(stdout);
    }
}

/**
 * @brief Key Event. Key event with the key code, state and modifier.
 *
 * @param[in] key_event Pointer to Key Event structure
 *
 */
static void key_event_callback(key_event_t *key_event)
{
    unsigned char key_char;

    hid_print_new_device_report_header(HID_PROTOCOL_KEYBOARD);

    if (KEY_STATE_PRESSED == key_event->state) {
        if (hid_keyboard_get_char(key_event->modifier,
                                  key_event->key_code, &key_char)) {

            hid_keyboard_print_char(key_char);

        }
    }
}

/**
 * @brief Key buffer scan code search.
 *
 * @param[in] src       Pointer to source buffer where to search
 * @param[in] key       Key scancode to search
 * @param[in] length    Size of the source buffer
 */
static inline bool key_found(const uint8_t *const src,
                             uint8_t key,
                             unsigned int length)
{
    for (unsigned int i = 0; i < length; i++) {
        if (src[i] == key) {
            return true;
        }
    }
    return false;
}

/**
 * @brief USB HID Host Keyboard Interface report callback handler
 *
 * @param[in] data    Pointer to input report data buffer
 * @param[in] length  Length of input report data buffer
 */
static void hid_host_keyboard_report_callback(const uint8_t *const data, const int length)
{
    hid_keyboard_input_report_boot_t *kb_report = (hid_keyboard_input_report_boot_t *)data;

    if (length < sizeof(hid_keyboard_input_report_boot_t)) {
        return;
    }

    static uint8_t prev_keys[HID_KEYBOARD_KEY_MAX] = { 0 };
    key_event_t key_event;

    for (int i = 0; i < HID_KEYBOARD_KEY_MAX; i++) {

        // key has been released verification
        if (prev_keys[i] > HID_KEY_ERROR_UNDEFINED &&
                !key_found(kb_report->key, prev_keys[i], HID_KEYBOARD_KEY_MAX)) {
            key_event.key_code = prev_keys[i];
            key_event.modifier = 0;
            key_event.state = KEY_STATE_RELEASED;
            key_event_callback(&key_event);
        }

        // key has been pressed verification
        if (kb_report->key[i] > HID_KEY_ERROR_UNDEFINED &&
                !key_found(prev_keys, kb_report->key[i], HID_KEYBOARD_KEY_MAX)) {
            key_event.key_code = kb_report->key[i];
            key_event.modifier = kb_report->modifier.val;
            key_event.state = KEY_STATE_PRESSED;
            key_event_callback(&key_event);

            // --- NEW: add newline for clarity ---
            printf("\n");
            fflush(stdout);

            // --- NEW: send and print serialised keyboard frame ---
            uart_send_framed('K', (const uint8_t *)kb_report, sizeof(*kb_report));

            uint8_t payload_len = sizeof(*kb_report);
            uint8_t hdr[3] = { SERIAL_MAGIC, 'K', payload_len };
            uint32_t sum = hdr[1] + hdr[2];
            for (int j = 0; j < payload_len; j++) sum += ((uint8_t*)kb_report)[j];
            uint8_t cs = (uint8_t)(0x100 - (sum & 0xFF));

            printf("  [UART Frame K] ");
            for (int j = 0; j < 3; j++) printf("%02X ", hdr[j]);
            for (int j = 0; j < payload_len; j++) printf("%02X ", ((uint8_t*)kb_report)[j]);
            printf("%02X\n", cs);   // checksum + newline
            fflush(stdout);

        }
    }

    memcpy(prev_keys, &kb_report->key, HID_KEYBOARD_KEY_MAX);



}

/**
 * @brief USB HID Host Mouse Interface report callback handler
 *
 * @param[in] data    Pointer to input report data buffer
 * @param[in] length  Length of input report data buffer
 */
static void hid_host_mouse_report_callback(const uint8_t *const data, const int length)
{
    hid_mouse_input_report_boot_t *mouse_report = (hid_mouse_input_report_boot_t *)data;

    if (length < sizeof(hid_mouse_input_report_boot_t)) {
        return;
    }

    static int x_pos = 0;
    static int y_pos = 0;

    // Calculate absolute position from displacement
    x_pos += mouse_report->x_displacement;
    y_pos += mouse_report->y_displacement;

    hid_print_new_device_report_header(HID_PROTOCOL_MOUSE);

    printf("X: %06d\tY: %06d\t|%c|%c|\n",
           x_pos, y_pos,
           (mouse_report->buttons.button1 ? 'o' : ' '),
           (mouse_report->buttons.button2 ? 'o' : ' '));
    fflush(stdout);

    uart_send_framed('M', (const uint8_t *)mouse_report, sizeof(*mouse_report));

    uint8_t payload_len = sizeof(*mouse_report);
    uint8_t hdr[3] = { SERIAL_MAGIC, 'M', payload_len };
    uint32_t sum = hdr[1] + hdr[2];
    for (int j = 0; j < payload_len; j++) sum += ((uint8_t*)mouse_report)[j];
    uint8_t cs = (uint8_t)(0x100 - (sum & 0xFF));

    printf("  [UART Frame M] ");
    for (int j = 0; j < 3; j++) printf("%02X ", hdr[j]);
    for (int j = 0; j < payload_len; j++) printf("%02X ", ((uint8_t*)mouse_report)[j]);
    printf("%02X\n", cs);
    fflush(stdout);

}

/**
 * @brief USB HID Host Generic Interface report callback handler
 *
 * 'generic' means anything else than mouse or keyboard
 *
 * @param[in] data    Pointer to input report data buffer
 * @param[in] length  Length of input report data buffer
 */
static void hid_host_generic_report_callback(const uint8_t *const data, const int length)
{
    hid_print_new_device_report_header(HID_PROTOCOL_NONE);
    for (int i = 0; i < length; i++) {
        printf("%02X", data[i]);
    }
    putchar('\r');
}

/**
 * @brief USB HID Host interface callback
 *
 * @param[in] hid_device_handle  HID Device handle
 * @param[in] event              HID Host interface event
 * @param[in] arg                Pointer to arguments, does not used
 */
void hid_host_interface_callback(hid_host_device_handle_t hid_device_handle,
                                 const hid_host_interface_event_t event,
                                 void *arg)
{
    uint8_t data[64] = { 0 };
    size_t data_length = 0;
    hid_host_dev_params_t dev_params;
    ESP_ERROR_CHECK(hid_host_device_get_params(hid_device_handle, &dev_params));

    switch (event) {
    case HID_HOST_INTERFACE_EVENT_INPUT_REPORT:
        
                    // ----- UART framing of every HID input report -----
                const uint8_t *rep      = NULL;
                size_t         rep_len  = 0;
                uint8_t        pkt_type = 'R'; // default 'raw' if proto is unknown

                /* Newer usb_host_hid (1.0.x) uses input_report.{data,length} */
        #if defined(HID_HOST_INTERFACE_EVENT_INPUT_REPORT)
                // If your callback signature provides a struct with input_report
                // e.g. const hid_host_interface_callback_event_t *ev
                // and you're inside: case HID_HOST_INTERFACE_EVENT_INPUT_REPORT:
                // Replace 'event' below with your actual pointer/variable name.
                // Examples seen in the wild:
                //   ev->input_report.data / ev->input_report.length
                //   event->input_report.data / event->input_report.length
                // ---- pick the one that matches your file ----
                rep     = event->input_report.data;
                rep_len = event->input_report.length;
        #endif

                /* Older variants expose raw pointers directly (fallback) */
                if (rep == NULL || rep_len == 0) {
                    // If your example uses names like 'data' and 'length', uncomment:
                    // rep     = event->data;
                    // rep_len = event->length;
                }
            
                /* Try to identify interface protocol to label packet type */
                // Many examples keep per-interface params or expose a getter.
                // If you have 'dev_params.proto' in scope, use it:
                //   if (dev_params.proto == HID_PROTOCOL_KEYBOARD) pkt_type = 'K';
                //   else if (dev_params.proto == HID_PROTOCOL_MOUSE) pkt_type = 'M';
                // Otherwise, leave as 'R' (raw).
            
                if (rep && rep_len) {
                    uart_send_framed(pkt_type, rep, rep_len);
                }
                // ----------------------------------------------------
    
        ESP_ERROR_CHECK(hid_host_device_get_raw_input_report_data(hid_device_handle,
                                                                  data,
                                                                  64,
                                                                  &data_length));

        if (HID_SUBCLASS_BOOT_INTERFACE == dev_params.sub_class) {
            if (HID_PROTOCOL_KEYBOARD == dev_params.proto) {
                hid_host_keyboard_report_callback(data, data_length);
            } else if (HID_PROTOCOL_MOUSE == dev_params.proto) {
                hid_host_mouse_report_callback(data, data_length);
            }
        } else {
            hid_host_generic_report_callback(data, data_length);
        }

        break;
    case HID_HOST_INTERFACE_EVENT_DISCONNECTED:
        ESP_LOGI(TAG, "HID Device, protocol '%s' DISCONNECTED",
                 hid_proto_name_str[dev_params.proto]);
        ESP_ERROR_CHECK(hid_host_device_close(hid_device_handle));
        break;
    case HID_HOST_INTERFACE_EVENT_TRANSFER_ERROR:
        ESP_LOGI(TAG, "HID Device, protocol '%s' TRANSFER_ERROR",
                 hid_proto_name_str[dev_params.proto]);
        break;
    default:
        ESP_LOGE(TAG, "HID Device, protocol '%s' Unhandled event",
                 hid_proto_name_str[dev_params.proto]);
        break;
    }
}

/**
 * @brief USB HID Host Device event
 *
 * @param[in] hid_device_handle  HID Device handle
 * @param[in] event              HID Host Device event
 * @param[in] arg                Pointer to arguments, does not used
 */
void hid_host_device_event(hid_host_device_handle_t hid_device_handle,
                           const hid_host_driver_event_t event,
                           void *arg)
{
    hid_host_dev_params_t dev_params;
    ESP_ERROR_CHECK(hid_host_device_get_params(hid_device_handle, &dev_params));

    switch (event) {
    case HID_HOST_DRIVER_EVENT_CONNECTED:
        ESP_LOGI(TAG, "HID Device, protocol '%s' CONNECTED",
                 hid_proto_name_str[dev_params.proto]);

        const hid_host_device_config_t dev_config = {
            .callback = hid_host_interface_callback,
            .callback_arg = NULL
        };

        if (dev_params.proto != HID_PROTOCOL_NONE) {
            ESP_ERROR_CHECK(hid_host_device_open(hid_device_handle, &dev_config));
            if (HID_SUBCLASS_BOOT_INTERFACE == dev_params.sub_class) {
                ESP_ERROR_CHECK(hid_class_request_set_protocol(hid_device_handle, HID_REPORT_PROTOCOL_BOOT));
                if (HID_PROTOCOL_KEYBOARD == dev_params.proto) {
                    ESP_ERROR_CHECK(hid_class_request_set_idle(hid_device_handle, 0, 0));
                }
            }
            ESP_ERROR_CHECK(hid_host_device_start(hid_device_handle));
        }
        break;
    default:
        break;
    }
}

/**
 * @brief Start USB Host install and handle common USB host library events while app pin not low
 *
 * @param[in] arg  Not used
 */
static void usb_lib_task(void *arg)
{
    const usb_host_config_t host_config = {
        .skip_phy_setup = false,
        .intr_flags = ESP_INTR_FLAG_LEVEL1,
    };

    ESP_ERROR_CHECK(usb_host_install(&host_config));
    xTaskNotifyGive(arg);

    while (true) {
        uint32_t event_flags;
        usb_host_lib_handle_events(portMAX_DELAY, &event_flags);
        // In this example, there is only one client registered
        // So, once we deregister the client, this call must succeed with ESP_OK
        if (event_flags & USB_HOST_LIB_EVENT_FLAGS_NO_CLIENTS) {
            ESP_ERROR_CHECK(usb_host_device_free_all());
            break;
        }
    }

    ESP_LOGI(TAG, "USB shutdown");
    // Clean up USB Host
    vTaskDelay(10); // Short delay to allow clients clean-up
    ESP_ERROR_CHECK(usb_host_uninstall());
    vTaskDelete(NULL);
}

/**
 * @brief BOOT button pressed callback
 *
 * Signal application to exit the HID Host task
 *
 * @param[in] arg Unused
 */
static void gpio_isr_cb(void *arg)
{
    BaseType_t xTaskWoken = pdFALSE;
    const app_event_queue_t evt_queue = {
        .event_group = APP_EVENT,
    };

    if (app_event_queue) {
        xQueueSendFromISR(app_event_queue, &evt_queue, &xTaskWoken);
    }

    if (xTaskWoken == pdTRUE) {
        portYIELD_FROM_ISR();
    }
}

/**
 * @brief HID Host Device callback
 *
 * Puts new HID Device event to the queue
 *
 * @param[in] hid_device_handle HID Device handle
 * @param[in] event             HID Device event
 * @param[in] arg               Not used
 */
void hid_host_device_callback(hid_host_device_handle_t hid_device_handle,
                              const hid_host_driver_event_t event,
                              void *arg)
{
    const app_event_queue_t evt_queue = {
        .event_group = APP_EVENT_HID_HOST,
        // HID Host Device related info
        .hid_host_device.handle = hid_device_handle,
        .hid_host_device.event = event,
        .hid_host_device.arg = arg
    };

    if (app_event_queue) {
        xQueueSend(app_event_queue, &evt_queue, 0);
    }
}

/************* TinyUSB descriptors ****************/

#define TUSB_DESC_TOTAL_LEN      (TUD_CONFIG_DESC_LEN + CFG_TUD_HID * TUD_HID_DESC_LEN)

/**
 * @brief HID report descriptor
 *
 * In this example we implement Keyboard + Mouse HID device,
 * so we must define both report descriptors
 */
const uint8_t hid_report_descriptor[] = {
    TUD_HID_REPORT_DESC_KEYBOARD(HID_REPORT_ID(HID_ITF_PROTOCOL_KEYBOARD)),
    TUD_HID_REPORT_DESC_MOUSE(HID_REPORT_ID(HID_ITF_PROTOCOL_MOUSE))
};

/**
 * @brief String descriptor
 */
const char *hid_string_descriptor[5] = {
    // array of pointer to string descriptors
    (char[]){0x09, 0x04},  // 0: is supported language is English (0x0409)
    "TinyUSB",             // 1: Manufacturer
    "TinyUSB Device",      // 2: Product
    "123456",              // 3: Serials, should use chip ID
    "Example HID interface",  // 4: HID
};

/**
 * @brief Configuration descriptor
 *
 * This is a simple configuration descriptor that defines 1 configuration and 1 HID interface
 */
static const uint8_t hid_configuration_descriptor[] = {
    // Configuration number, interface count, string index, total length, attribute, power in mA
    TUD_CONFIG_DESCRIPTOR(1, 1, 0, TUSB_DESC_TOTAL_LEN, TUSB_DESC_CONFIG_ATT_REMOTE_WAKEUP, 100),

    // Interface number, string index, boot protocol, report descriptor len, EP In address, size & polling interval
    TUD_HID_DESCRIPTOR(0, 4, false, sizeof(hid_report_descriptor), 0x81, 16, 10),
};

/********* TinyUSB HID callbacks ***************/

// Invoked when received GET HID REPORT DESCRIPTOR request
// Application return pointer to descriptor, whose contents must exist long enough for transfer to complete
uint8_t const *tud_hid_descriptor_report_cb(uint8_t instance)
{
    // We use only one interface and one HID report descriptor, so we can ignore parameter 'instance'
    return hid_report_descriptor;
}

// Invoked when received GET_REPORT control request
// Application must fill buffer report's content and return its length.
// Return zero will cause the stack to STALL request
uint16_t tud_hid_get_report_cb(uint8_t instance, uint8_t report_id, hid_report_type_t report_type, uint8_t *buffer, uint16_t reqlen)
{
    (void) instance;
    (void) report_id;
    (void) report_type;
    (void) buffer;
    (void) reqlen;

    return 0;
}

// Invoked when received SET_REPORT control request or
// received data on OUT endpoint ( Report ID = 0, Type = 0 )
void tud_hid_set_report_cb(uint8_t instance, uint8_t report_id, hid_report_type_t report_type, uint8_t const *buffer, uint16_t bufsize)
{
}

/********* Application ***************/

// <--- NEW: helper to print a frame in hex
static void print_frame_hex(const char *tag, uint8_t *frame, int len) {
    printf("%s ", tag);
    for (int i = 0; i < len; i++) {
        printf("%02X ", frame[i]);
    }
    printf("\n");
}

typedef enum {
    MOUSE_DIR_RIGHT,
    MOUSE_DIR_DOWN,
    MOUSE_DIR_LEFT,
    MOUSE_DIR_UP,
    MOUSE_DIR_MAX,
} mouse_dir_t;

#define DISTANCE_MAX        125
#define DELTA_SCALAR        5

// <--- NEW checksum helper
static bool validate_checksum(uint8_t *frame, int len) {
    if (len < 4) return false; // too short

    //print the raw frame
    print_frame_hex("[RX Frame]", frame, len);

    uint8_t type = frame[1];
    uint8_t payload_len = frame[2];

    //make sure payload length in header matches received data and frame is correct
    if (len != payload_len + 4) {
        ESP_LOGW("UART_RX", "Frame length mismatch! Expected %d, got %d", payload_len + 4, len);
        return false;
    }

    uint32_t sum = type + payload_len;
    for (int i = 0; i < payload_len; i++) {
        sum += frame[3 + i]; // payload starts at frame[3]
    }

    uint8_t expected = (uint8_t)(0x100 - (sum & 0xFF));
    uint8_t received = frame[len - 1];

    if (received == expected) {
        ESP_LOGI("UART_RX", "Checksum OK (0x%02X)", received);
        return true;
    } else {
        ESP_LOGW("UART_RX", "Checksum FAIL: got 0x%02X, expected 0x%02X", received, expected);
        return false;
    }
}


static void mouse_draw_square_next_delta(int8_t *delta_x_ret, int8_t *delta_y_ret)
{
    static mouse_dir_t cur_dir = MOUSE_DIR_RIGHT;
    static uint32_t distance = 0;

    // Calculate next delta
    if (cur_dir == MOUSE_DIR_RIGHT) {
        *delta_x_ret = DELTA_SCALAR;
        *delta_y_ret = 0;
    } else if (cur_dir == MOUSE_DIR_DOWN) {
        *delta_x_ret = 0;
        *delta_y_ret = DELTA_SCALAR;
    } else if (cur_dir == MOUSE_DIR_LEFT) {
        *delta_x_ret = -DELTA_SCALAR;
        *delta_y_ret = 0;
    } else if (cur_dir == MOUSE_DIR_UP) {
        *delta_x_ret = 0;
        *delta_y_ret = -DELTA_SCALAR;
    }

    // Update cumulative distance for current direction
    distance += DELTA_SCALAR;
    // Check if we need to change direction
    if (distance >= DISTANCE_MAX) {
        distance = 0;
        cur_dir++;
        if (cur_dir == MOUSE_DIR_MAX) {
            cur_dir = 0;
        }
    }
}

static void app_send_hid_demo(void)
{
    // Keyboard output: Send key 'a/A' pressed and released
    ESP_LOGI(TAG, "Sending Keyboard report");
    uint8_t keycode[6] = {HID_KEY_A};
    tud_hid_keyboard_report(HID_ITF_PROTOCOL_KEYBOARD, 0, keycode);
    vTaskDelay(pdMS_TO_TICKS(50));
    tud_hid_keyboard_report(HID_ITF_PROTOCOL_KEYBOARD, 0, NULL);

    // Mouse output: Move mouse cursor in square trajectory
    ESP_LOGI(TAG, "Sending Mouse report");
    int8_t delta_x;
    int8_t delta_y;
    for (int i = 0; i < (DISTANCE_MAX / DELTA_SCALAR) * 4; i++) {
        // Get the next x and y delta in the draw square pattern
        mouse_draw_square_next_delta(&delta_x, &delta_y);
        tud_hid_mouse_report(HID_ITF_PROTOCOL_MOUSE, 0x00, delta_x, delta_y, 0, 0);
        vTaskDelay(pdMS_TO_TICKS(20));
    }
}

static void uart_rx_task(void *arg)
{
    uint8_t data[UART_BUF_SIZE];
    char log_buf[128];

    while (1) {
        int len = uart_read_bytes(UART_PORT_NUM, data, sizeof(data), pdMS_TO_TICKS(100));
        if (len > 0) {
            // Only process frames starting with 0xA5
            if (data[0] == 0xA5) {
                if (validate_checksum(data, len)) {
                    // Keyboard frame
                    if (data[1] == 'K') {
                        uint8_t modifier = data[3];
                        uint8_t keycode  = data[5];
                        char ascii = '?';
                        if (keycode >= 0x04 && keycode <= 0x1D) {
                            ascii = 'A' + keycode - 0x04;
                        }

                        // Log human-readable data
                        snprintf(log_buf, sizeof(log_buf),
                                 "Keyboard Received: Modifier=0x%02X, Keycode=0x%02X ('%c')\n",
                                 modifier, keycode, ascii);
                        uart_write_bytes(UART_PORT_NUM, log_buf, strlen(log_buf));

                        // ALSO print to console monitor
                        ESP_LOGI("HID_RX", "%s", log_buf);

                        // Inject HID report
                        uint8_t keycode_array[6] = {0};
                        keycode_array[0] = keycode;
                        tud_hid_keyboard_report(0, modifier, keycode_array);
                    }
                    // Mouse frame
                    else if (data[1] == 'M') {
                        uint8_t buttons = data[2];
                        int8_t dx = (int8_t)data[3];
                        int8_t dy = (int8_t)data[4];

                        // Human-readable buttons
                        char buttons_str[32] = "";
                        if (buttons & 0x01) strcat(buttons_str, "Left ");
                        if (buttons & 0x02) strcat(buttons_str, "Right ");
                        if (buttons & 0x04) strcat(buttons_str, "Middle ");

                        // Log human-readable data
                        snprintf(log_buf, sizeof(log_buf),
                                 "Mouse Received: Buttons=%s, dx=%d, dy=%d\n",
                                 buttons_str, dx, dy);
                        uart_write_bytes(UART_PORT_NUM, log_buf, strlen(log_buf));

                        // ALSO print to console monitor
                        ESP_LOGI("HID_RX", "%s", log_buf);

                        // Inject HID report
                        tud_hid_mouse_report(0, buttons, dx, dy, 0, 0);
                    }
                } else {
                    ESP_LOGW("UART_RX", "Discarded invalid frame");
                }
            }
        }
    }
}

void app_main(void)
{
    BaseType_t task_created;
    app_event_queue_t evt_queue;
    ESP_LOGI(TAG, "HID Host example");

    // Initialize UART1 TX on GPIO17 for serialized HID output
    uart_init();

    // Init BOOT button: Pressing the button simulates app request to exit
    // It will disconnect the USB device and uninstall the HID driver and USB Host Lib
    const gpio_config_t input_pin = {
        .pin_bit_mask = BIT64(APP_QUIT_PIN),
        .mode = GPIO_MODE_INPUT,
        .pull_up_en = GPIO_PULLUP_ENABLE,
        .intr_type = GPIO_INTR_NEGEDGE,
    };
    ESP_ERROR_CHECK(gpio_config(&input_pin));
    ESP_ERROR_CHECK(gpio_install_isr_service(ESP_INTR_FLAG_LEVEL1));
    ESP_ERROR_CHECK(gpio_isr_handler_add(APP_QUIT_PIN, gpio_isr_cb, NULL));

//hid device
        ESP_LOGI(TAG, "USB initialization");
        const tinyusb_config_t tusb_cfg = {
            .device_descriptor = NULL,
            .string_descriptor = hid_string_descriptor,
            .string_descriptor_count = sizeof(hid_string_descriptor) / sizeof(hid_string_descriptor[0]),
            .external_phy = false,
    #if (TUD_OPT_HIGH_SPEED)
            .fs_configuration_descriptor = hid_configuration_descriptor, // HID configuration descriptor for full-speed and high-speed are the same
            .hs_configuration_descriptor = hid_configuration_descriptor,
            .qualifier_descriptor = NULL,
    #else
            .configuration_descriptor = hid_configuration_descriptor,
    #endif // TUD_OPT_HIGH_SPEED
        };

        // <--- NEW UART init section
        uart_config_t uart_config = {
            .baud_rate = UART_BAUD_RATE,
            .data_bits = UART_DATA_8_BITS,
            .parity    = UART_PARITY_DISABLE,
            .stop_bits = UART_STOP_BITS_1,
            .flow_ctrl = UART_HW_FLOWCTRL_DISABLE,
        };
        ESP_ERROR_CHECK(uart_driver_install(UART_PORT_NUM, UART_BUF_SIZE, 0, 10, &uart_queue, 0));
        ESP_ERROR_CHECK(uart_param_config(UART_PORT_NUM, &uart_config));
        ESP_ERROR_CHECK(uart_set_pin(UART_PORT_NUM,
                                UART_PIN_NO_CHANGE,   // TX not used
                                UART_RX_PIN,          // RX pin = GPIO18
                                UART_PIN_NO_CHANGE,   // RTS
                                UART_PIN_NO_CHANGE)); // CTS

        xTaskCreate(uart_rx_task, "uart_rx_task", 4096, NULL, 5, NULL);

        ESP_ERROR_CHECK(tinyusb_driver_install(&tusb_cfg));
        ESP_LOGI(TAG, "USB initialization DONE");

        while (1) {
            if (tud_mounted()) {
                static bool send_hid_data = true;
                if (send_hid_data) {
                    app_send_hid_demo();
                }
                send_hid_data = !gpio_get_level(APP_BUTTON);
            }
            vTaskDelay(pdMS_TO_TICKS(100));
        }

    
    //hid host
    /*
    * Create usb_lib_task to:
    * - initialize USB Host library
    * - Handle USB Host events while APP pin in in HIGH state
    */
    task_created = xTaskCreatePinnedToCore(usb_lib_task,
                                           "usb_events",
                                           4096,
                                           xTaskGetCurrentTaskHandle(),
                                           2, NULL, 0);
    assert(task_created == pdTRUE);

    // Wait for notification from usb_lib_task to proceed
    ulTaskNotifyTake(false, 1000);

    /*
    * HID host driver configuration
    * - create background task for handling low level event inside the HID driver
    * - provide the device callback to get new HID Device connection event
    */
    const hid_host_driver_config_t hid_host_driver_config = {
        .create_background_task = true,
        .task_priority = 5,
        .stack_size = 4096,
        .core_id = 0,
        .callback = hid_host_device_callback,
        .callback_arg = NULL
    };

    ESP_ERROR_CHECK(hid_host_install(&hid_host_driver_config));

    // Create queue
    app_event_queue = xQueueCreate(10, sizeof(app_event_queue_t));

    ESP_LOGI(TAG, "Waiting for HID Device to be connected");

    while (1) {
        // Wait queue
        if (xQueueReceive(app_event_queue, &evt_queue, portMAX_DELAY)) {
            if (APP_EVENT == evt_queue.event_group) {
                // User pressed button
                usb_host_lib_info_t lib_info;
                ESP_ERROR_CHECK(usb_host_lib_info(&lib_info));
                if (lib_info.num_devices == 0) {
                    // End while cycle
                    break;
                } else {
                    ESP_LOGW(TAG, "To shutdown example, remove all USB devices and press button again.");
                    // Keep polling
                }
            }

            if (APP_EVENT_HID_HOST ==  evt_queue.event_group) {
                hid_host_device_event(evt_queue.hid_host_device.handle,
                                      evt_queue.hid_host_device.event,
                                      evt_queue.hid_host_device.arg);
            }
        }
    }

    ESP_LOGI(TAG, "HID Driver uninstall");
    ESP_ERROR_CHECK(hid_host_uninstall());
    gpio_isr_handler_remove(APP_QUIT_PIN);
    xQueueReset(app_event_queue);
    vQueueDelete(app_event_queue);
}
