abbydes/ELEC5550_Group08_GITHUB/(commit log)

2025-09-11 PROTOTYPE folder renamed
2025-09-11 Create PCB PROTOTYPING
2025-09-23 Create ledpatch
2025-09-29 Update and rename HIDhid_device_v5_LED to HIDhid_device_v5_LED.c
    Fixed issues with LED. Correctly flashes
    [HIDhid_device_v5_LED.c]
2025-10-03 Create UART_bridge_B_V1
2025-10-03 Create UART_bridge_A_V1
2025-10-10 Update UART_bridge_B_V1
2025-10-24 Add README with modifications for USB-MSC example
    This README outlines modifications made to the USB-MSC device example, including files to verify and modify for successful builds.
2025-10-27 Implement USB MSC host functionality for Board B
    This commit adds a comprehensive implementation for Board B as a USB MSC host, including handshake protocols, UART configuration, and handling of READ10 and WRITE10 SCSI commands.
2025-10-27 Create KiCAD PCB
